StarostinaPolina/Growbox/README.md

# GrowBox

## Для кого это устройство

Устройство ориентировано в первую очередь на **садоводов, выращивающих растения в гроубоксах, шкафах или небольших теплицах**, и в целом на тех, кто проводит много времени, ухаживая за растениями в замкнутом пространстве, — то есть в условиях, где регулярный воздухообмен и регулировка температуры, освещённости особенно важны».

> Гроубокс часто держат закрытым из-за запаха, шума вентиляторов или уличной пыли, а вспоминают о проветривании только тогда, когда растения начинают задыхаться или когда в боксе уже нечем дышать.
Автоматическая регулировка вентиляции, полива и освещения, а также уведомления об этом могут помочь людям, занимающимся выращиванием цветов и зелени.
## Почему это важно

Исследования показывают:

| Параметр | Отклонение от нормы | Влияние на растения |
| :--- | :--- | :--- |
| **Температура** | > 30°C | Тепловой стресс, увядание, риск гермафродитизма |
| **Влажность** | > 70% | Риск плесени, гнили и грибковых заболеваний |

То есть духота и перегрев в гроубоксе — это не просто недочёт, а **прямое снижение скорости фотосинтеза, замедление набора биомассы и падение урожайности**.

## Как это решает «GrowBox»

«GrowBox» снимает эту задачу с человека: устройство само следит за уровнем **полива, температуры и влажности** и управляет вентиляцией (форточкой, клапаном или вытяжкой) тогда, когда это нужно, — не отвлекая человека от работы и не требуя от него постоянно проверять датчики и вручную крутить ручки.

## Особенно практично в проекте

*   🛌 **Не нужно вставать** — можно не отвлекаться от работы или сна, чтобы проветрить бокс.
*   🤯 **Не нужно беспокоиться**, что забыл закрыть вентиляцию перед сном или уходом (и растения замерзли/перегрелись).
*   🌿 **Создаются комфортные и здоровые условия** для роста и цветения.
*   🤲 **Без лишних усилий** со стороны самого человека — автоматика работает сама.
