StarostinaPolina/Growbox/BOM_growbox.pdf

## Список компонентов для закупки (ВОМ)

### для проекта «Гроубокс для выращивания зелени с управлением через мобильное приложение»

- Контроллер: ESP32 (https://www.ozon.ru/product/esp32-modul-esp32-type-c-ch340c-wi-fi-bluetooth-3881360381/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)
- Блок питания 220V AC to 12V DC: SWG S-75-12 (https://www.ozon.ru/product/swg-bloki-pitaniya-svetodiodnoy-lenty-12v-75vt-s-75-12-1522872101/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)
- Плата для ESP32 (https://github.com/m112521/bots) (рис. 1)
- Датчик температуры и влажности воздуха: SHT41 (https://www.ozon.ru/product/sht40-sht41-sht45-tsifrovye-datchiki-temperatury-i-vlazhnosti-2995545961/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) 3В
- Датчик влажности почвы Arduino (https://www.ozon.ru/product/datchik-vlazhnosti-pochvy-arduino-datchik-poliva-848776655/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) 3В
- Датчик уровня воды Arduino (https://www.ozon.ru/product/datchik-urovnya-vody-arduino-1854897905/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) 3В
- Вентиляторы: Кулер Gembird FANPS 12В (https://www.ozon.ru/product/kuler-dlya-protsessora-pk-gembird-fanps-kuler-80x80x25-vtulka-2-pin-provod-30-sm-291757748/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) — 2 шт
- Насос 12В (взять на Фабрике)
- Светодиодная лента: Светодиодная лента ToonMark 12В, 9,6 Вт/м, 6500К (https://www.ozon.ru/product/svetodiodnaya-lenta-5m-12v-9-6-vt-m-6500k-holodnyy-cvet-1763986377/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) – 2

метра

1


Рис. 1: Плата

2
