StarostinaPolina/Growbox/cad models/watering_can.stl

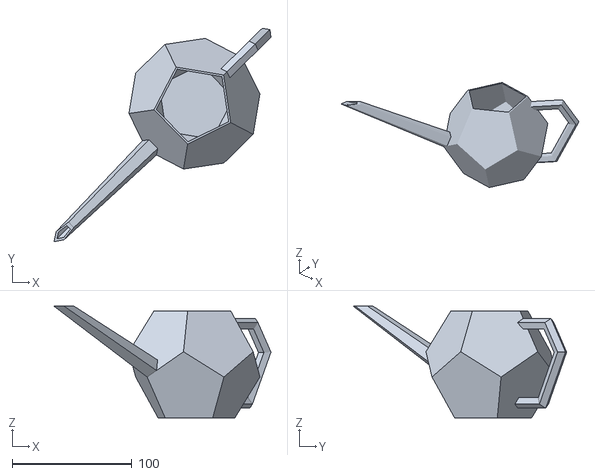
[picture p11: CAD file, 2026-11-13]
cad models/watering_can.stl
181.6 x 178.6 x 93.6
