StarostinaPolina/Growbox/cad models/Pot_01.stl

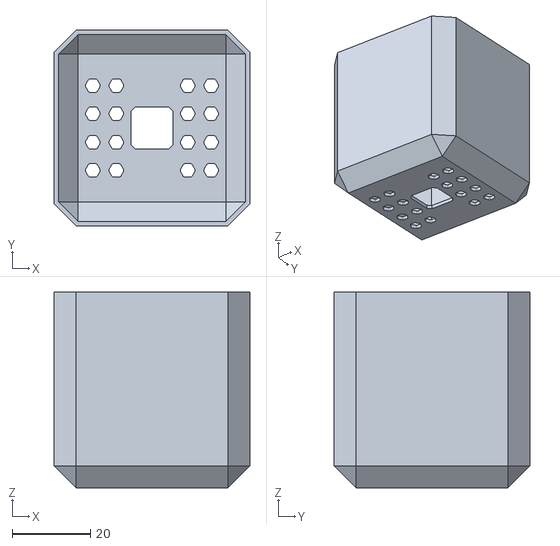
[picture p12: CAD file, 2026-11-13]
cad models/Pot_01.stl
50.0 x 50.0 x 50.0
