StarostinaPolina/Growbox/cad models/Basin_3x3.stl

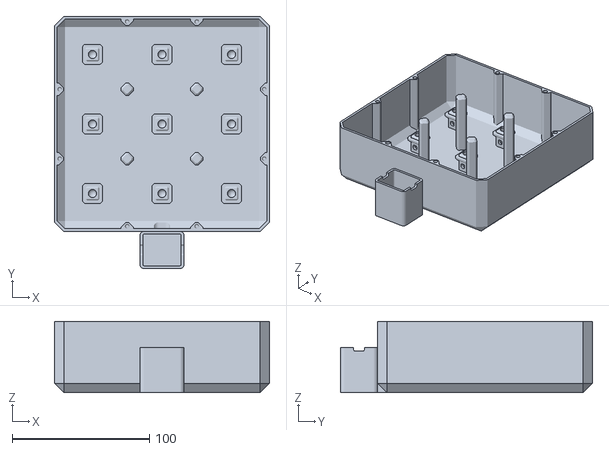
[picture p13: CAD file, 2026-11-13]
cad models/Basin_3x3.stl
156.4 x 183.4 x 52.0
