StarostinaPolina/Growbox/cad models/elect_case.stl

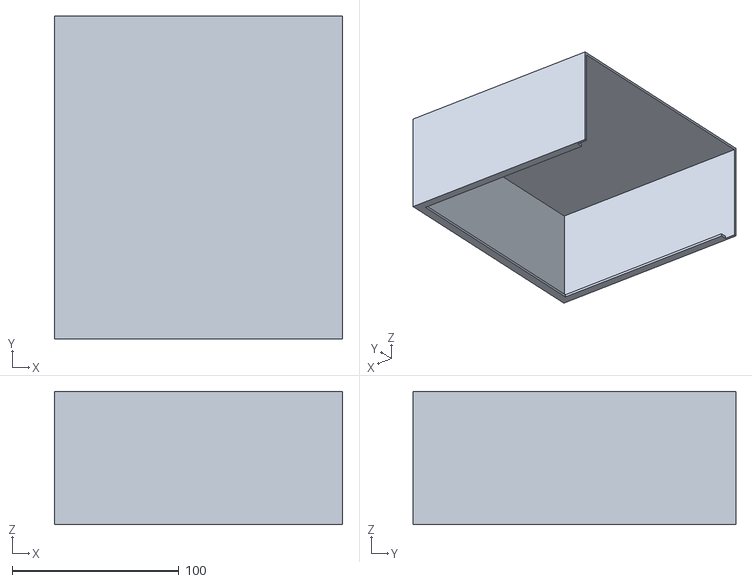
[picture p14: CAD file, 2026-11-13]
cad models/elect_case.stl
173.0 x 194.0 x 80.0
