StarostinaPolina/Growbox/cad models/all_walls_with_dims.dxf

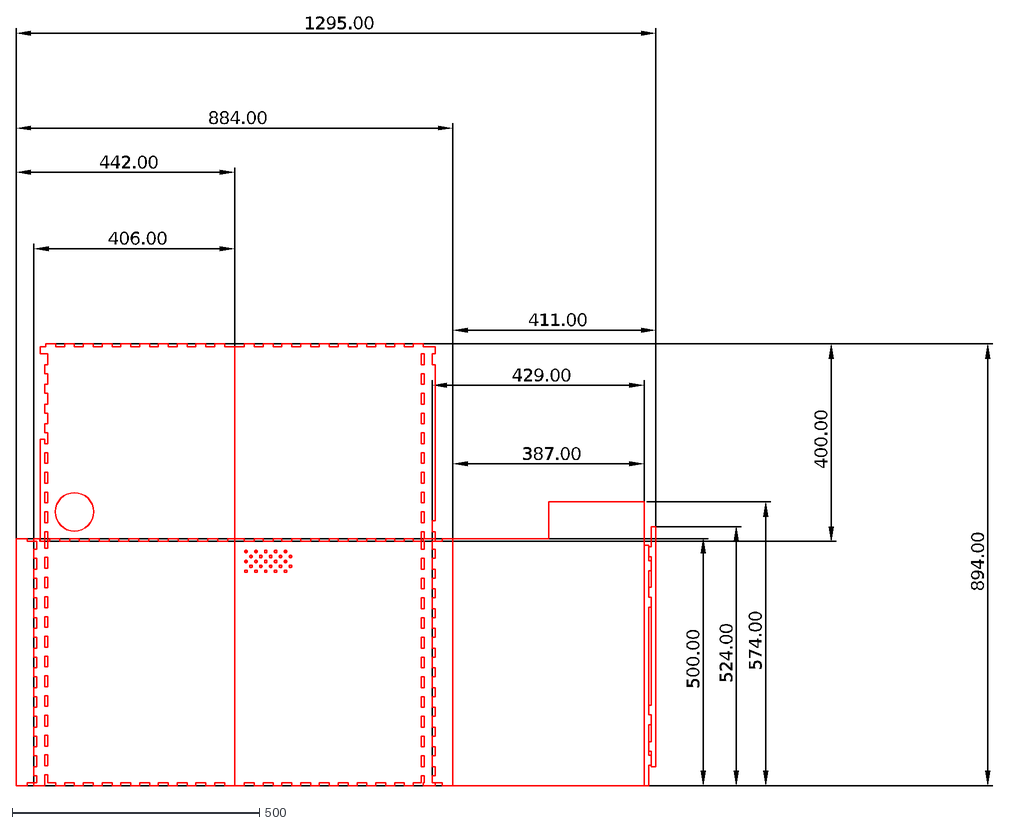
[picture p15: CAD file, 2026-11-13]
cad models/all_walls_with_dims.dxf
894.00
400.00
574.00
524.00
500.00
1295.00
429.00
411.00
387.00
884.00
406.00
442.00
