StarostinaPolina/Growbox/cad models/pump_case.stl

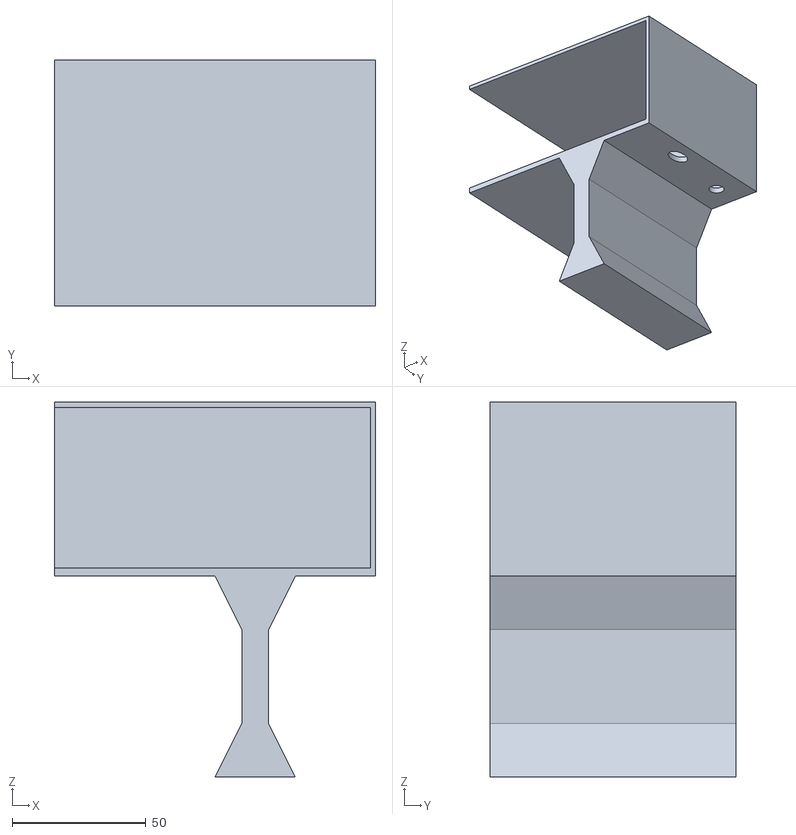
[picture p16: CAD file, 2026-11-13]
cad models/pump_case.stl
120.0 x 92.0 x 140.0
