StarostinaPolina/Growbox/cad models/holders.stl

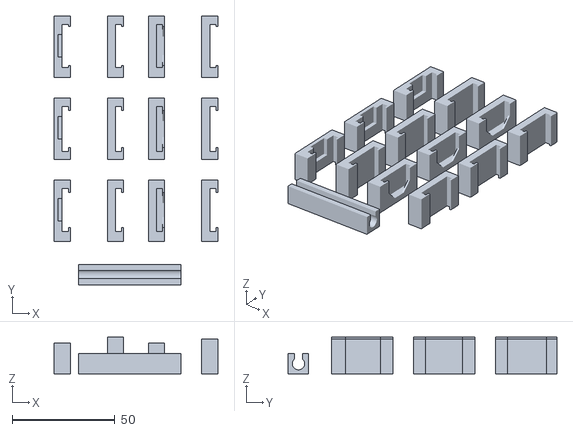
[picture p17: CAD file, 2026-11-13]
cad models/holders.stl
80.0 x 131.0 x 18.0
