StarostinaPolina/Growbox/cad models/first.stp

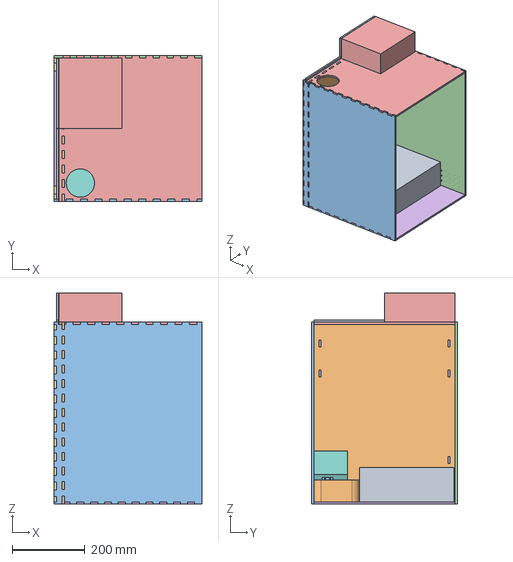
[picture p18: CAD file, 2026-11-12]
cad models/first.stp
406.0 x 400.0 x 580.0 mm
