StarostinaPolina/Growbox/(list of files, cad)

Other CAD files:
cad models/prom.3dm
