StarostinaPolina/Growbox/(commit log)

2026-09-13 добавлено пп и вом
2026-11-12 Папка с файлами проекта
    Добавлен исходный код для PlatformIO (C++)
2026-11-12 Create corpus
    cad модель для корпуса growbox!
2026-11-12 Add files via upload
    cad модель для корпуса
    [first.stp]
2026-11-13 Add files via upload
    added cad models
    [all_walls_with_dims.dxf, elect_case.stl, holders.stl, prom.3dm, pump_case.stl]
2026-11-13 pots for plants
    [Basin_3x3.stl, Pot_01.stl, watering_can.stl]
2026-11-13 sample for site
